stevens-armlab/modular-continuum-manipulator-2.0/Actuation Unit/Nitinol Cable Mount Assembly.SLDASM

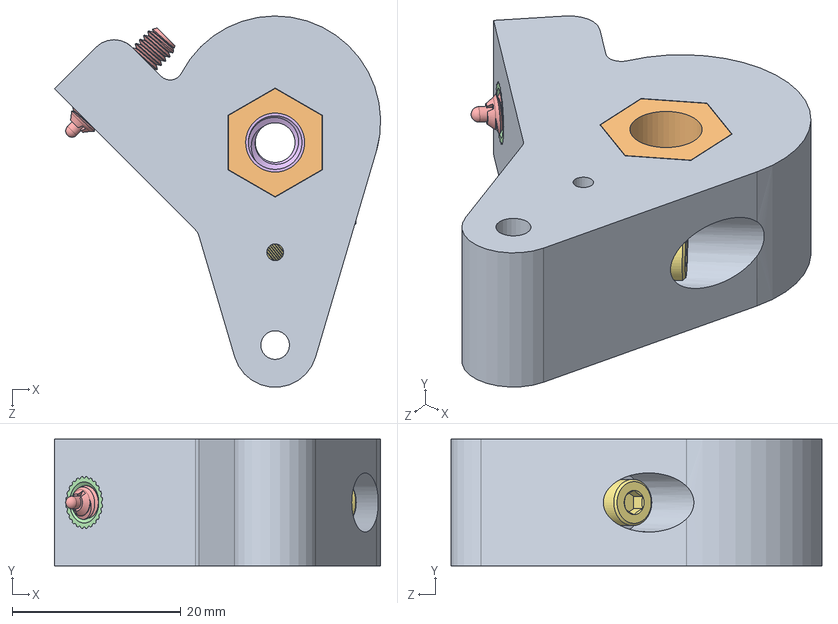
[picture p3: CAD file, 2023-07-17]
Actuation Unit/Nitinol Cable Mount Assembly.SLDASM
38.7 x 15.0 x 44.0 mm
Nitinol Cable Mount V2
Nitinol Cable Mount Cap
M3 - 4.3mm Heat Set Insert
M4 - 8.2mm Heat Set Insert
M4x0.7 - Long-Nose Spring Plunger
1_4-20 - 18-8 SS HEX NUT
M3x0.5 - 8mm - 18-8 SS SOCKET HEAD SCREW
