stevens-armlab/modular-continuum-manipulator-2.0/Continuum Arm Model/Arm Link Assembly.SLDASM

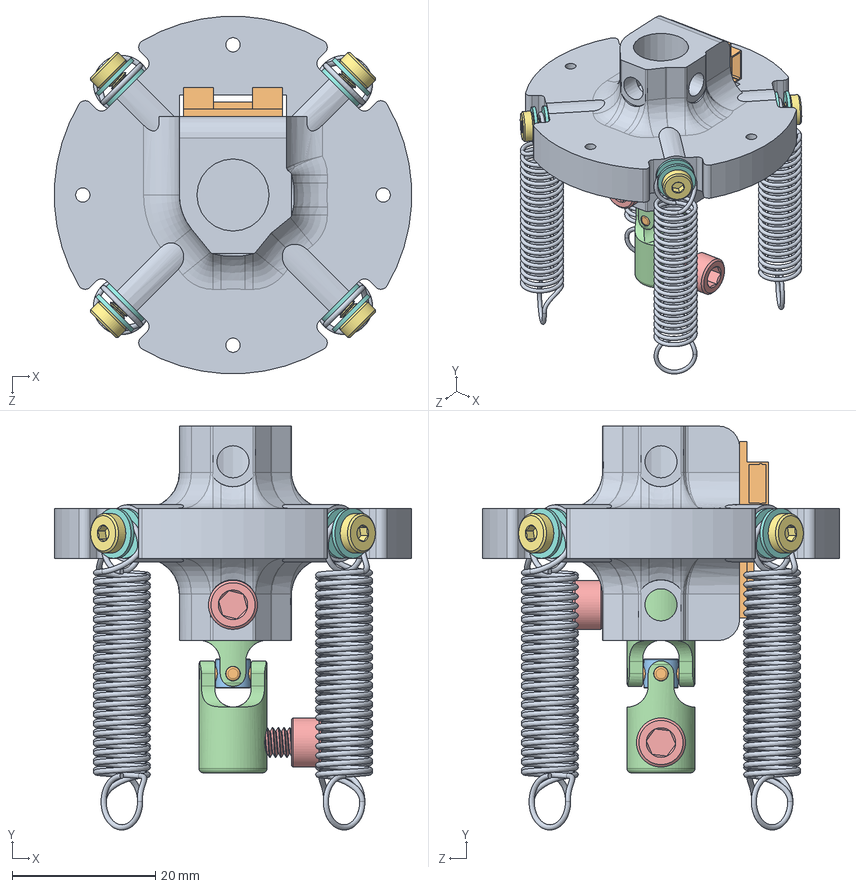
[picture p4: CAD file, 2023-07-17]
Continuum Arm Model/Arm Link Assembly.SLDASM
49.9 x 56.5 x 49.9 mm
Arm Link
VEX Joint Pin x 2
VEX Joint Ball
VEX Joint Link x 2
#8-32 x 0.3125in 18-8 Stainless Steel Socket Head Screw x 2
M3 - 5.7 mm Heat Set Insert x 4
M3x0.5 - 10mm - 18-8 SS LOW PROFILE SOCKET x 4
M3 - 18-8 STAINLESS STEEL FLAT WASHER x 8
0.313in x 1.25in Steel Extension Spring x 4
ZIO BNO080 part
