stevens-armlab/modular-continuum-manipulator-2.0/Waterproof Enclosure/WTE4-ASM-R2/WTE4-ASM-R2.SLDPRT

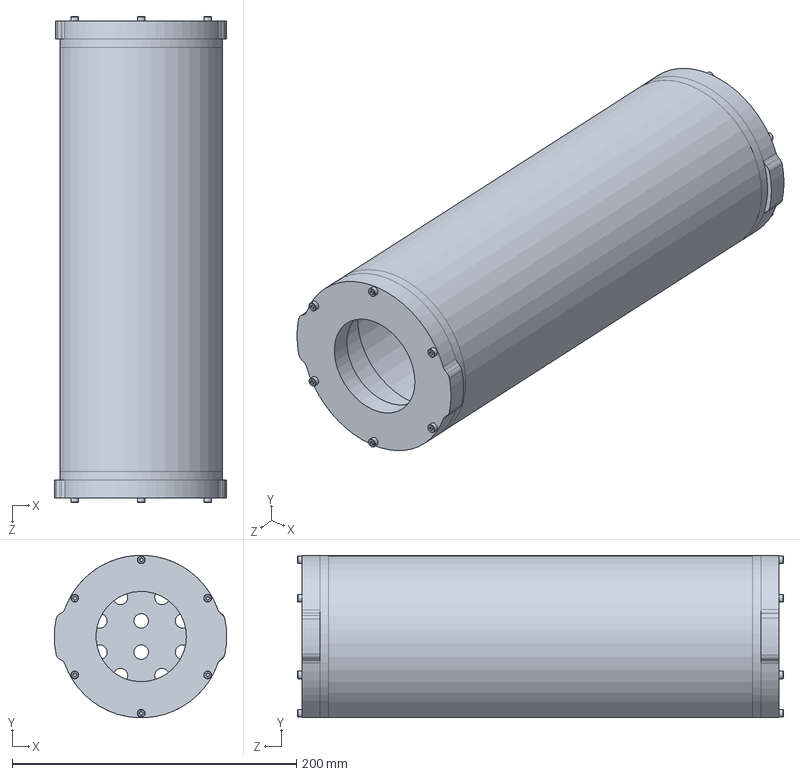
[picture p5: CAD file, 2022-06-02]
Waterproof Enclosure/WTE4-ASM-R2/WTE4-ASM-R2.SLDPRT
121.3 x 114.2 x 341.9 mm
