stevens-armlab/modular-continuum-manipulator-2.0/Actuation Unit/ThinPot Assembly.SLDASM

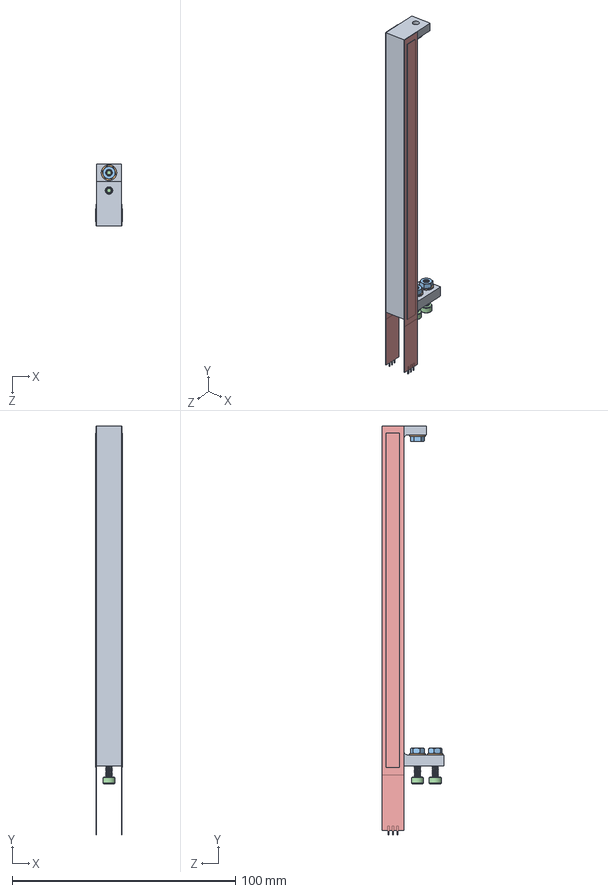
[picture p6: CAD file, 2023-07-17]
Actuation Unit/ThinPot Assembly.SLDASM
12.0 x 183.4 x 28.0 mm
ThinPot Mount 4in
M3 - 18-8 STAINLESS STEEL FLAT WASHER x 3
M3 - 18-8 STAINLESS STEEL HEX NUT x 3
M3x0.5 - 12mm - 18-8 SS SOCKET HEAD SCREW x 2
ThinPot 150mm x 2
