stevens-armlab/modular-continuum-manipulator-2.0/Continuum Arm Model/VEX Universal Joint.SLDASM

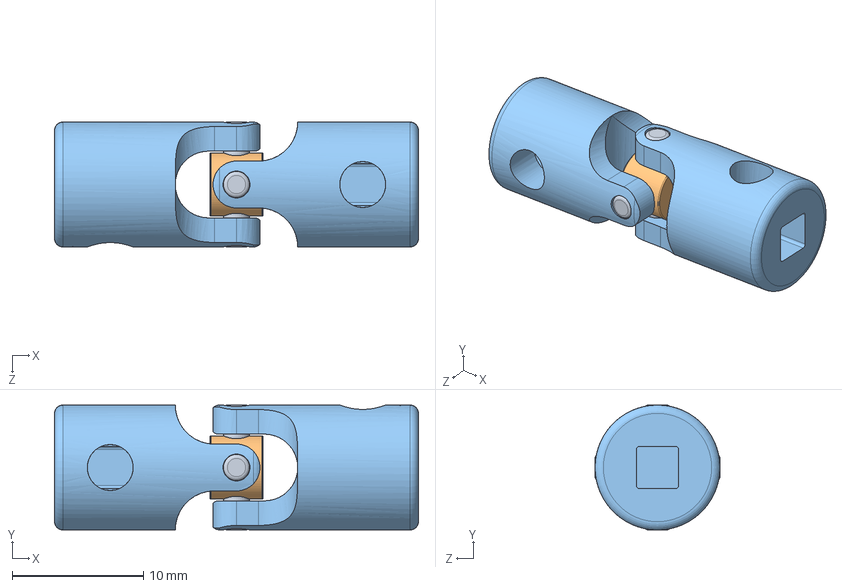
[picture p7: CAD file, 2022-06-02]
Continuum Arm Model/VEX Universal Joint.SLDASM
27.8 x 9.53 x 9.53 mm
VEX Joint Pin x 2
VEX Joint Ball
VEX Joint Link x 2
