stevens-armlab/modular-continuum-manipulator-2.0/Waterproof Enclosure/WTE6-ASM-R1.SLDPRT

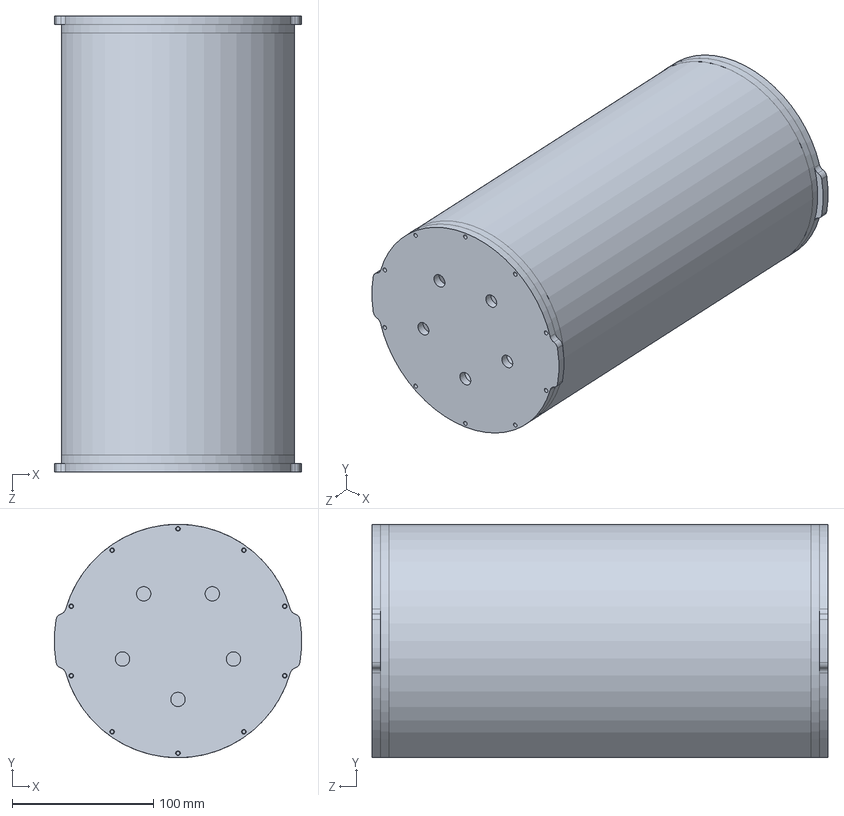
[picture p8: CAD file, 2022-06-02]
Waterproof Enclosure/WTE6-ASM-R1.SLDPRT
174.8 x 165.1 x 322.5 mm
