stevens-armlab/modular-continuum-manipulator-2.0/Bellows/Bellows Medium.SLDPRT

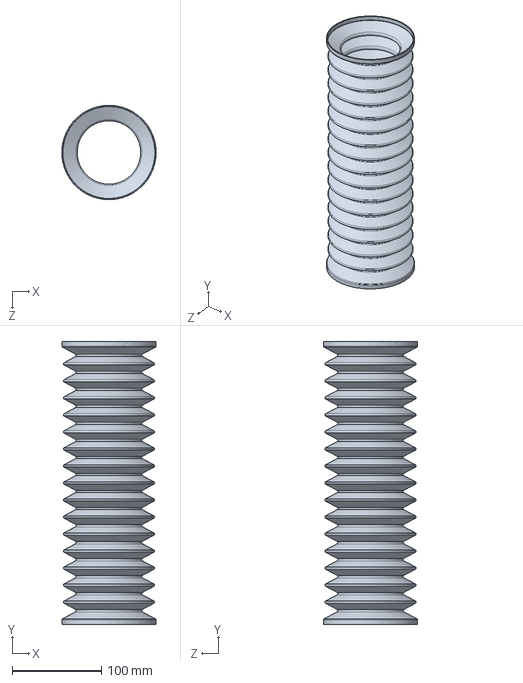
[picture p9: CAD file, 2023-07-17]
Bellows/Bellows Medium.SLDPRT
105.8 x 317.5 x 105.9 mm
