stevens-armlab/modular-continuum-manipulator-2.0/Bellows/Cap Medium.SLDPRT

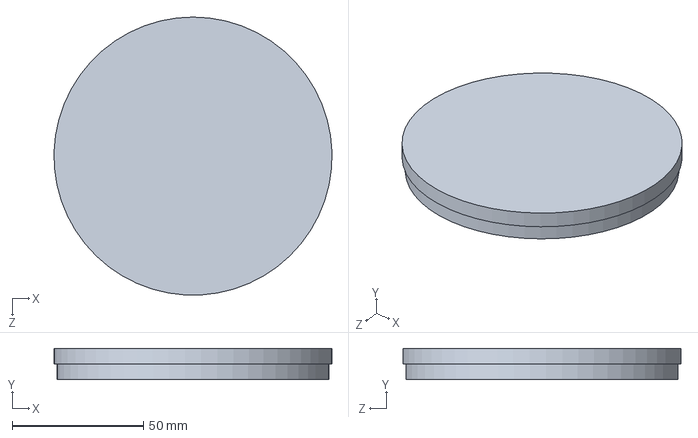
[picture p11: CAD file, 2023-07-17]
Bellows/Cap Medium.SLDPRT
105.9 x 11.9 x 105.8 mm
