stevens-armlab/modular-continuum-manipulator-2.0/Continuum Arm Model/VEX Joint Pin.sldprt

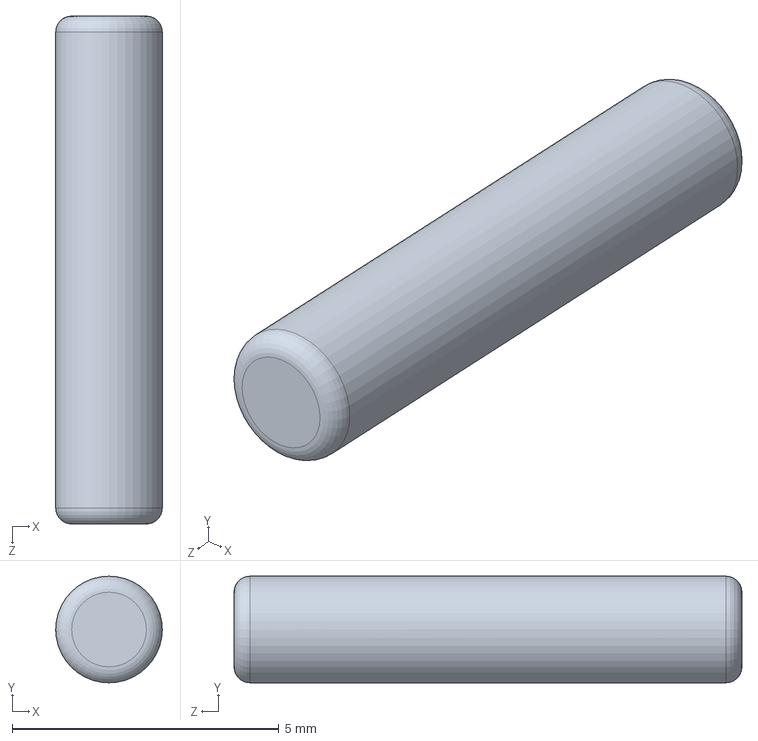
[picture p12: CAD file, 2022-06-02]
Continuum Arm Model/VEX Joint Pin.sldprt
2.00 x 2.00 x 9.53 mm
