stevens-armlab/modular-continuum-manipulator-2.0/Waterproof Enclosure/PENETRATOR-M-BLANK-10-25-R3.SLDPRT

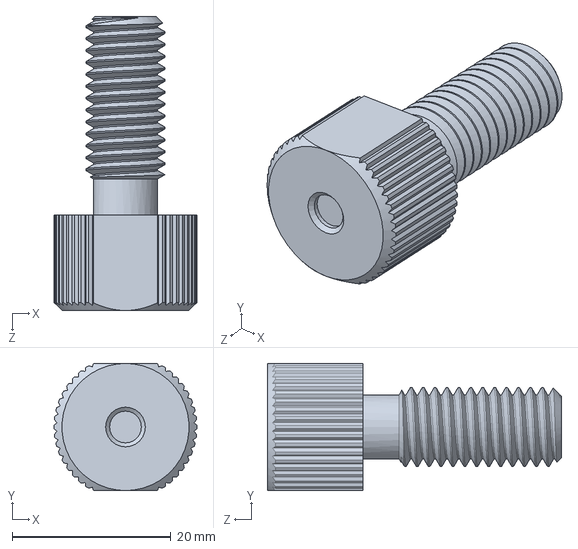
[picture p13: CAD file, 2022-06-02]
Waterproof Enclosure/PENETRATOR-M-BLANK-10-25-R3.SLDPRT
18.0 x 16.0 x 37.0 mm
