stevens-armlab/modular-continuum-manipulator-2.0/Actuation Unit/Nitinol Cable Mount V2.SLDPRT

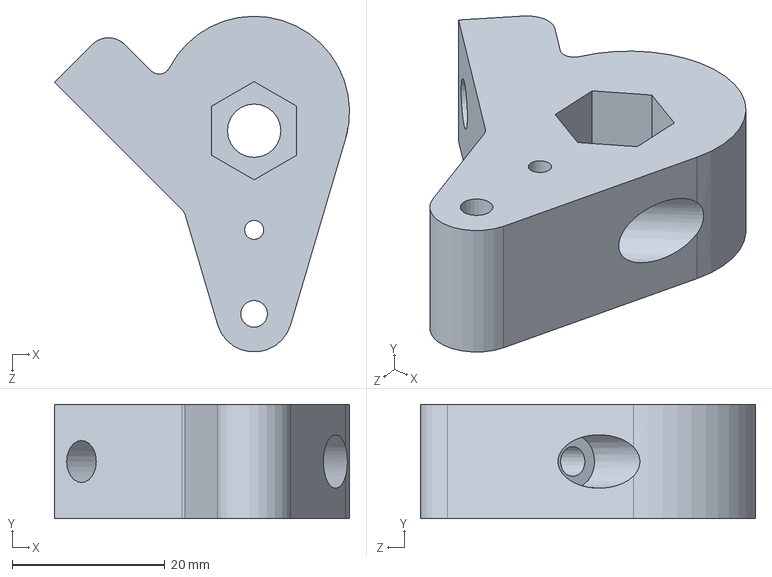
[picture p14: CAD file, 2022-06-16]
Actuation Unit/Nitinol Cable Mount V2.SLDPRT
38.7 x 15.0 x 44.0 mm
