stevens-armlab/modular-continuum-manipulator-2.0/Bellows/Joint Medium.SLDPRT

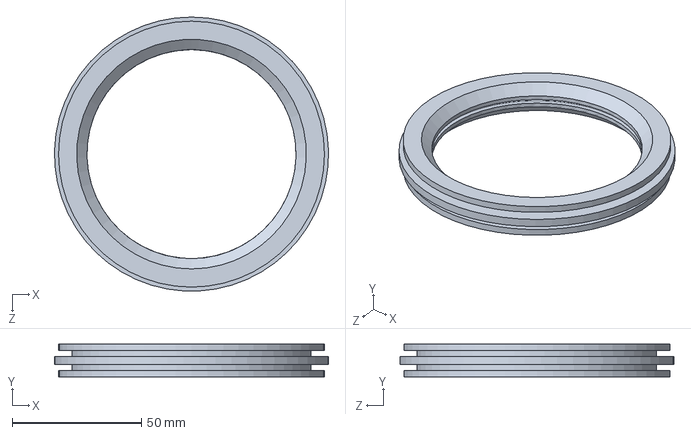
[picture p15: CAD file, 2023-07-17]
Bellows/Joint Medium.SLDPRT
105.9 x 12.7 x 105.8 mm
