stevens-armlab/modular-continuum-manipulator-2.0/Actuation Unit/Standoff Support.SLDPRT

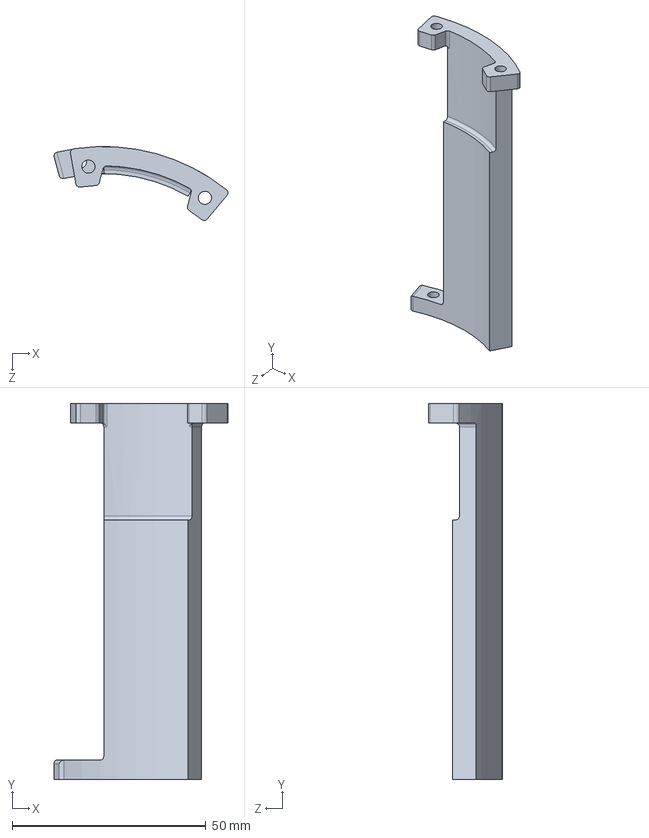
[picture p17: CAD file, 2022-06-16]
Actuation Unit/Standoff Support.SLDPRT
44.9 x 97.0 x 19.1 mm
