stevens-armlab/modular-continuum-manipulator-2.0/Bellows/Disc Medium.SLDPRT

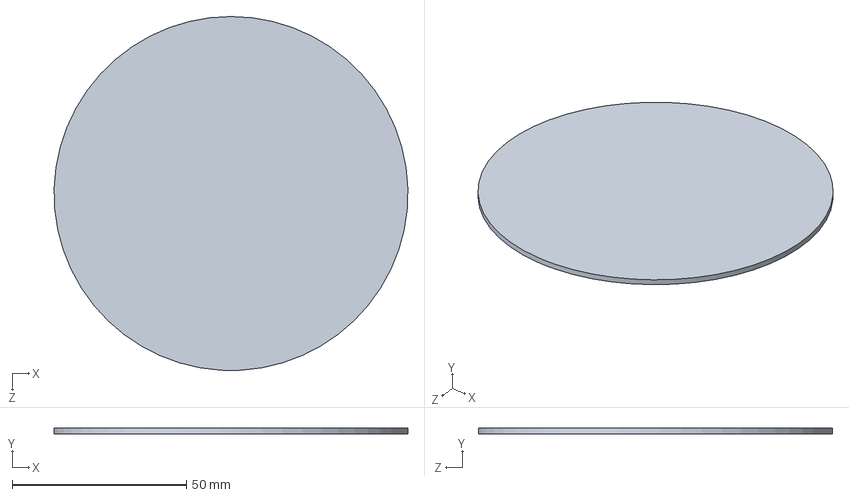
[picture p18: CAD file, 2023-07-17]
Bellows/Disc Medium.SLDPRT
101.6 x 1.59 x 101.6 mm
