stevens-armlab/modular-continuum-manipulator-2.0/Continuum Arm Model/Arm Link.SLDPRT

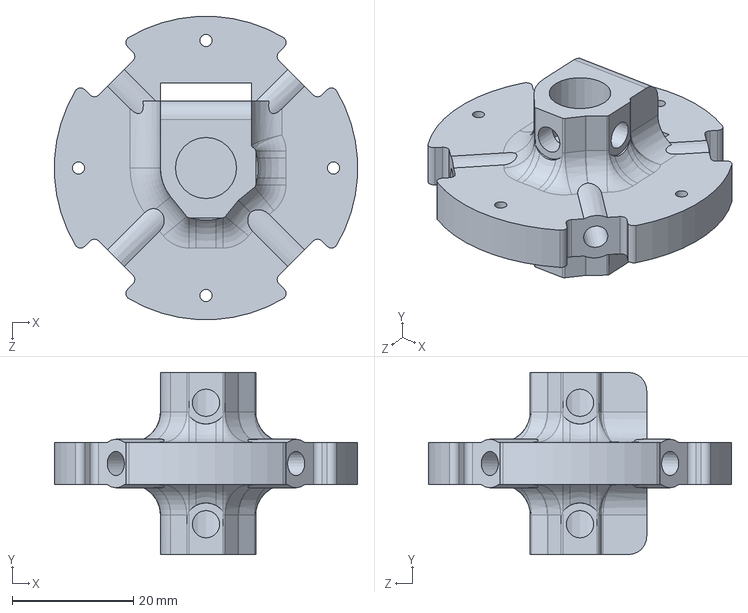
[picture p19: CAD file, 2022-06-02]
Continuum Arm Model/Arm Link.SLDPRT
49.9 x 30.0 x 49.9 mm
