stevens-armlab/modular-continuum-manipulator-2.0/Actuation Unit/ThinPot Mount 4in.SLDPRT

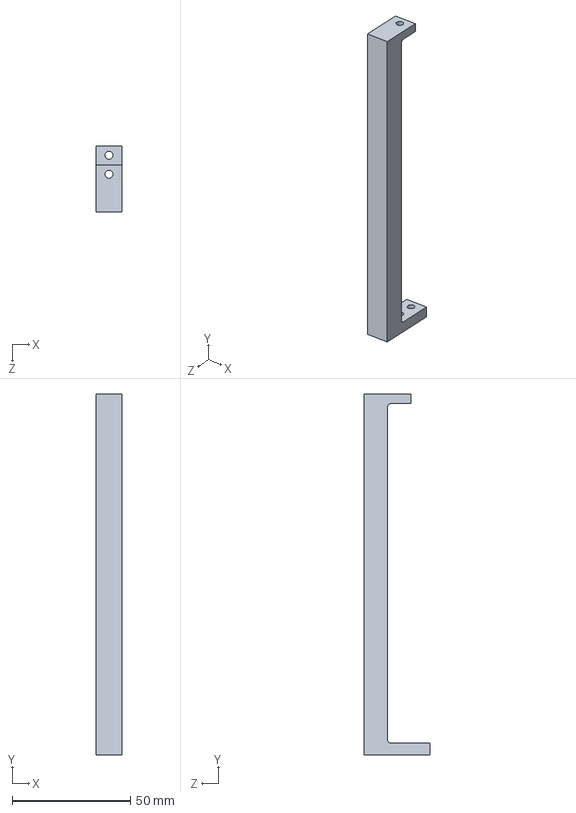
[picture p20: CAD file, 2022-06-02]
Actuation Unit/ThinPot Mount 4in.SLDPRT
11.0 x 152.4 x 28.0 mm
