stevens-armlab/modular-continuum-manipulator-2.0/Bellows/Cap Medium Cutout.SLDPRT

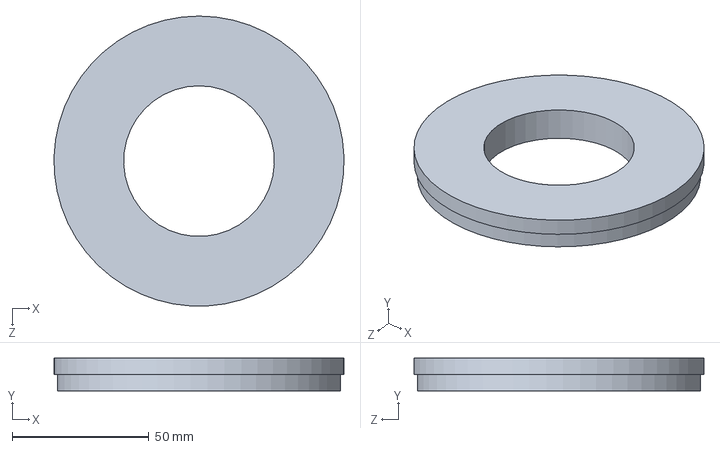
[picture p21: CAD file, 2023-07-17]
Bellows/Cap Medium Cutout.SLDPRT
105.9 x 11.9 x 105.8 mm
