stevens-armlab/modular-continuum-manipulator-2.0/Continuum Arm Model/VEX Joint Ball.sldprt

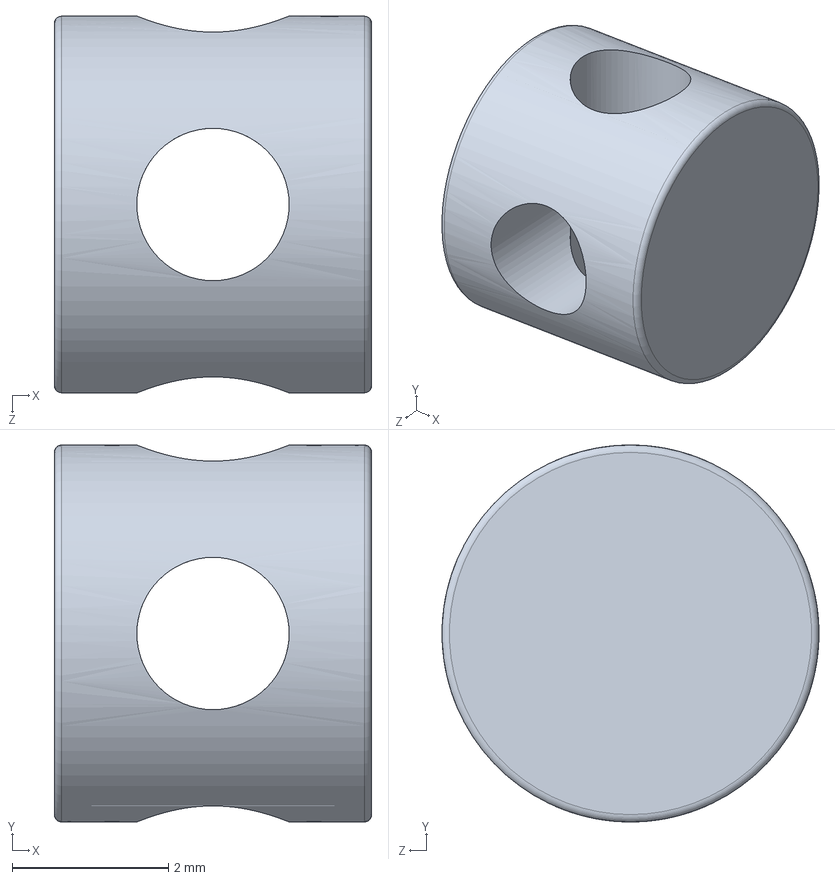
[picture p22: CAD file, 2022-06-02]
Continuum Arm Model/VEX Joint Ball.sldprt
4.06 x 4.83 x 4.83 mm
