stevens-armlab/modular-continuum-manipulator-2.0/Waterproof Enclosure/WTE6-M-END-CAP-R1.SLDPRT

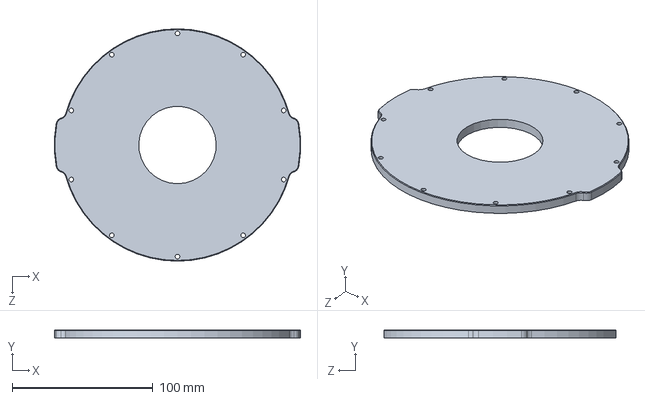
[picture p23: CAD file, 2022-06-02]
Waterproof Enclosure/WTE6-M-END-CAP-R1.SLDPRT
174.8 x 6.00 x 165.1 mm
