stevens-armlab/modular-continuum-manipulator-2.0/Actuation Unit/Top Plate 4in.SLDPRT

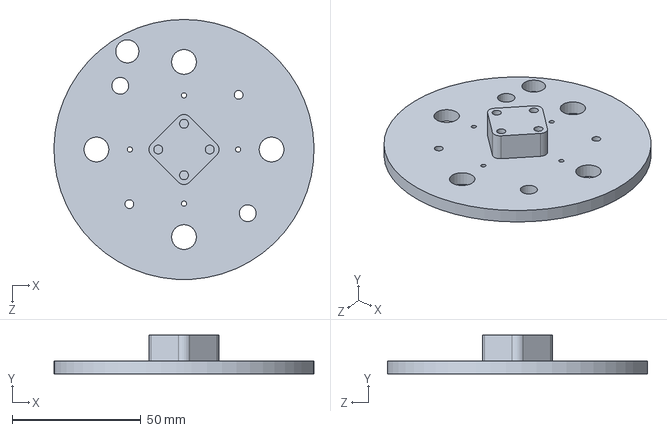
[picture p24: CAD file, 2022-06-02]
Actuation Unit/Top Plate 4in.SLDPRT
101.0 x 15.0 x 101.0 mm
