stevens-armlab/modular-continuum-manipulator-2.0/Bellows/Bellows Medium Bending.SLDPRT

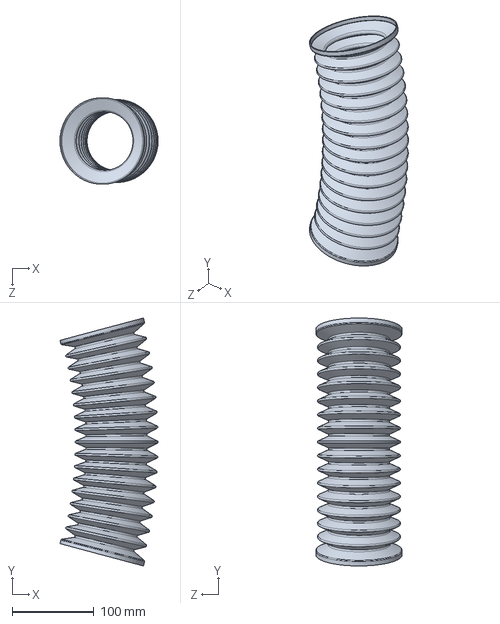
[picture p25: CAD file, 2023-07-17]
Bellows/Bellows Medium Bending.SLDPRT
120.2 x 303.6 x 105.9 mm
