stevens-armlab/modular-continuum-manipulator-2.0/Continuum Arm Model/End Link Nitinol Mount.SLDPRT

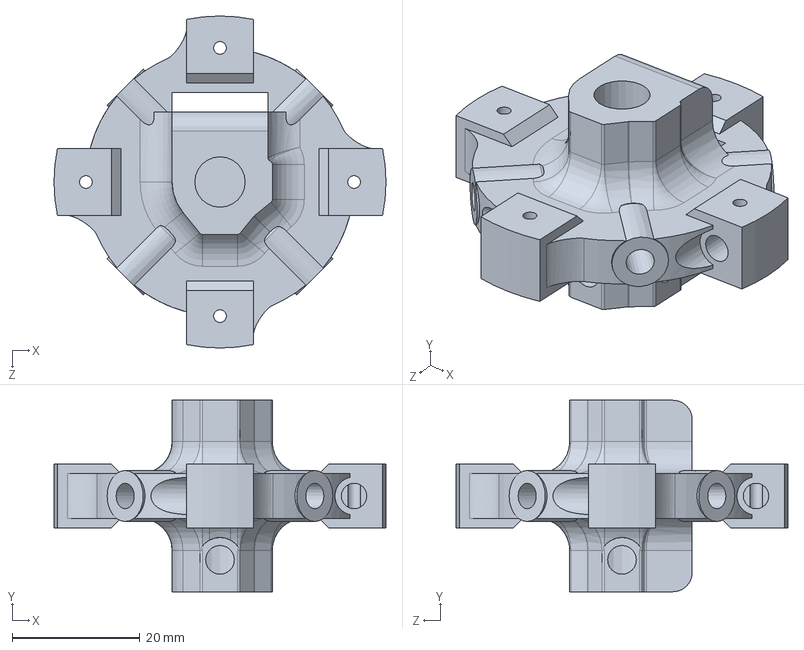
[picture p26: CAD file, 2022-06-02]
Continuum Arm Model/End Link Nitinol Mount.SLDPRT
52.0 x 30.0 x 52.0 mm
