stevens-armlab/modular-continuum-manipulator-2.0/Actuation Unit/Electronics Plate.SLDPRT

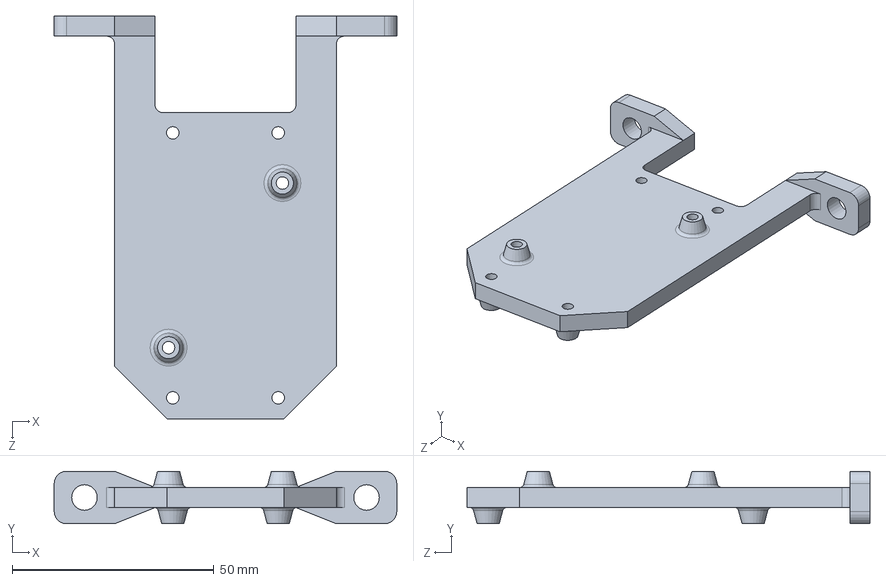
[picture p27: CAD file, 2022-06-02]
Actuation Unit/Electronics Plate.SLDPRT
85.0 x 13.0 x 100.0 mm
