stevens-armlab/modular-continuum-manipulator-2.0/Bellows/Alignment Disc.SLDPRT

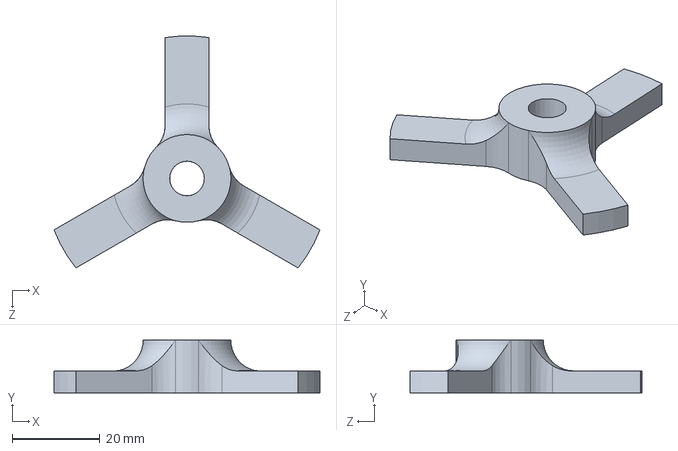
[picture p28: CAD file, 2022-06-02]
Bellows/Alignment Disc.SLDPRT
60.6 x 12.0 x 52.8 mm
