stevens-armlab/modular-continuum-manipulator-2.0/Continuum Arm Model/VEX Joint Link.sldprt

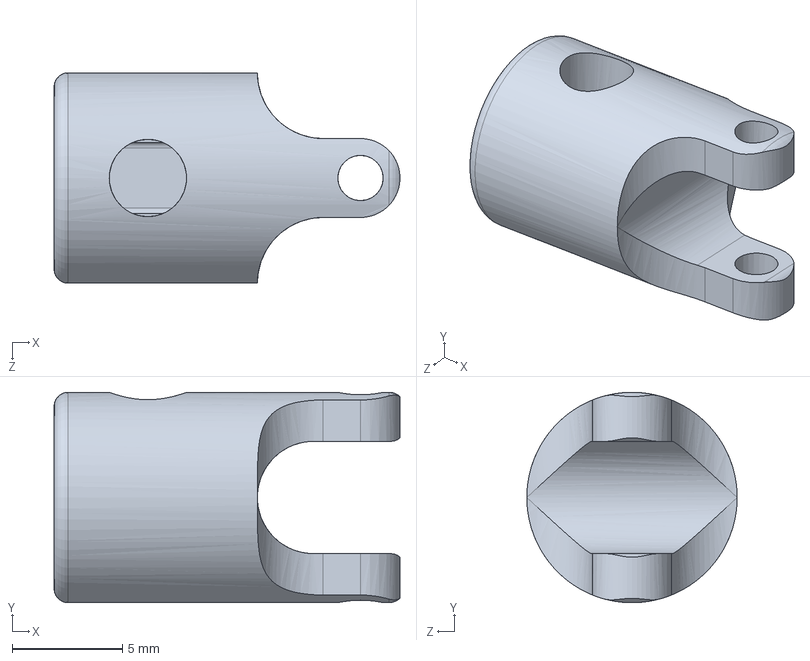
[picture p29: CAD file, 2022-06-02]
Continuum Arm Model/VEX Joint Link.sldprt
15.7 x 9.53 x 9.53 mm
