stevens-armlab/modular-continuum-manipulator-2.0/Waterproof Enclosure/WTE6-M-FLANGE-SEAL-R1.SLDPRT

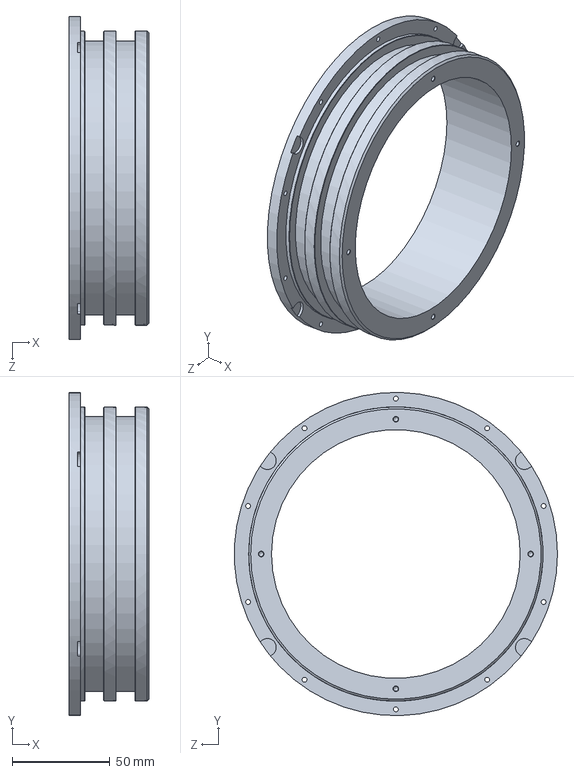
[picture p30: CAD file, 2022-06-02]
Waterproof Enclosure/WTE6-M-FLANGE-SEAL-R1.SLDPRT
41.0 x 165.0 x 165.0 mm
