stevens-armlab/modular-continuum-manipulator-2.0/Continuum Arm Model/ZIO QWIIC MUX.SLDPRT

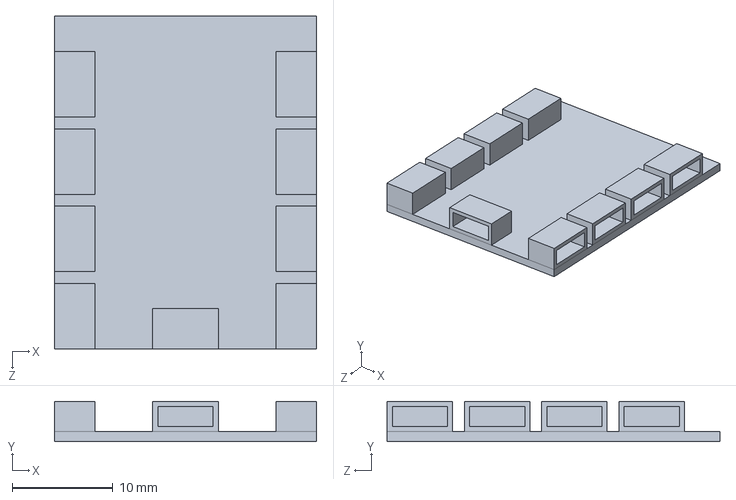
[picture p31: CAD file, 2022-06-02]
Continuum Arm Model/ZIO QWIIC MUX.SLDPRT
26.0 x 4.00 x 33.0 mm
