stevens-armlab/modular-continuum-manipulator-2.0/Waterproof Enclosure/WTE6-P-TUBE-12-R1.SLDPRT

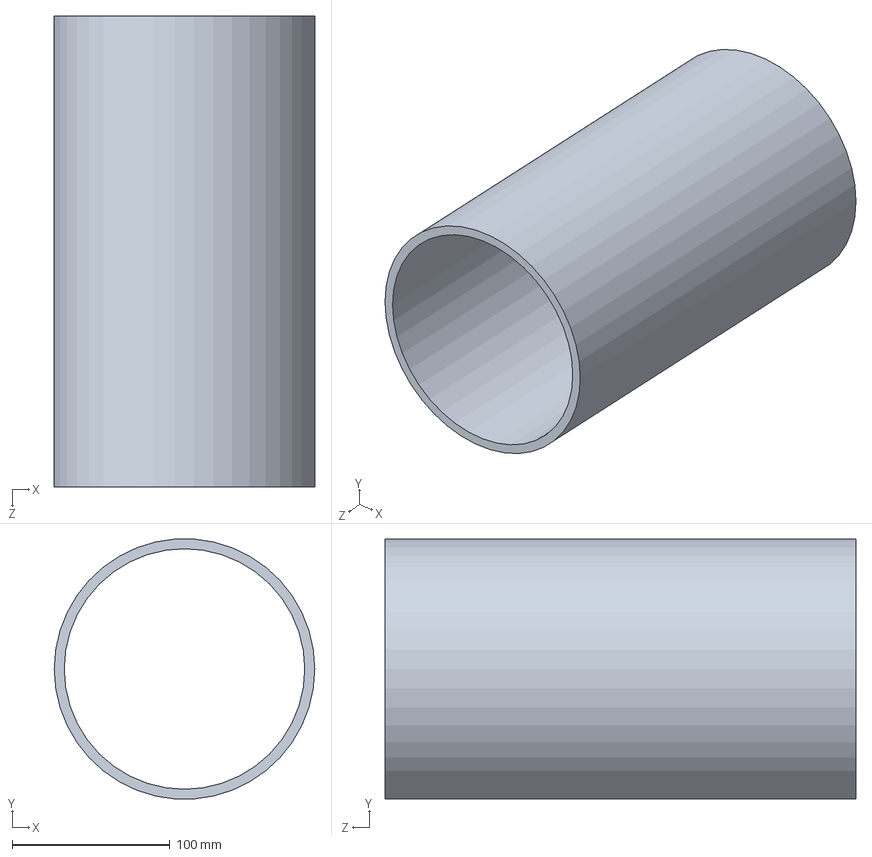
[picture p32: CAD file, 2022-06-02]
Waterproof Enclosure/WTE6-P-TUBE-12-R1.SLDPRT
165.1 x 164.6 x 298.4 mm
