stevens-armlab/modular-continuum-manipulator-2.0/Continuum Arm Model/Arm Base Lower.SLDPRT

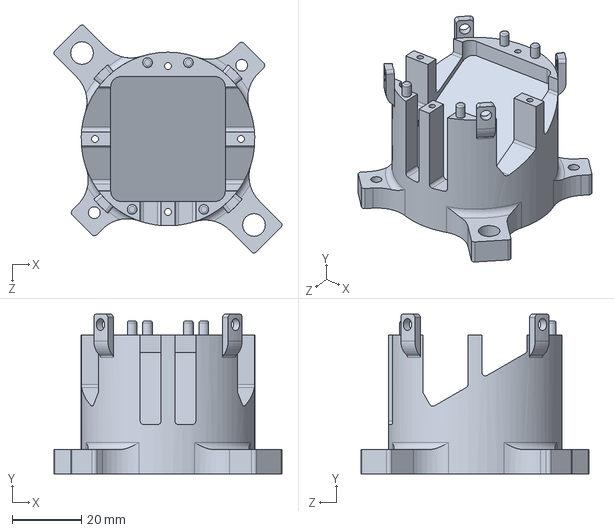
[picture p33: CAD file, 2022-06-02]
Continuum Arm Model/Arm Base Lower.SLDPRT
65.6 x 46.0 x 65.6 mm
