stevens-armlab/modular-continuum-manipulator-2.0/Waterproof Enclosure/VENT-M-PLUG-10-A-R3.SLDPRT

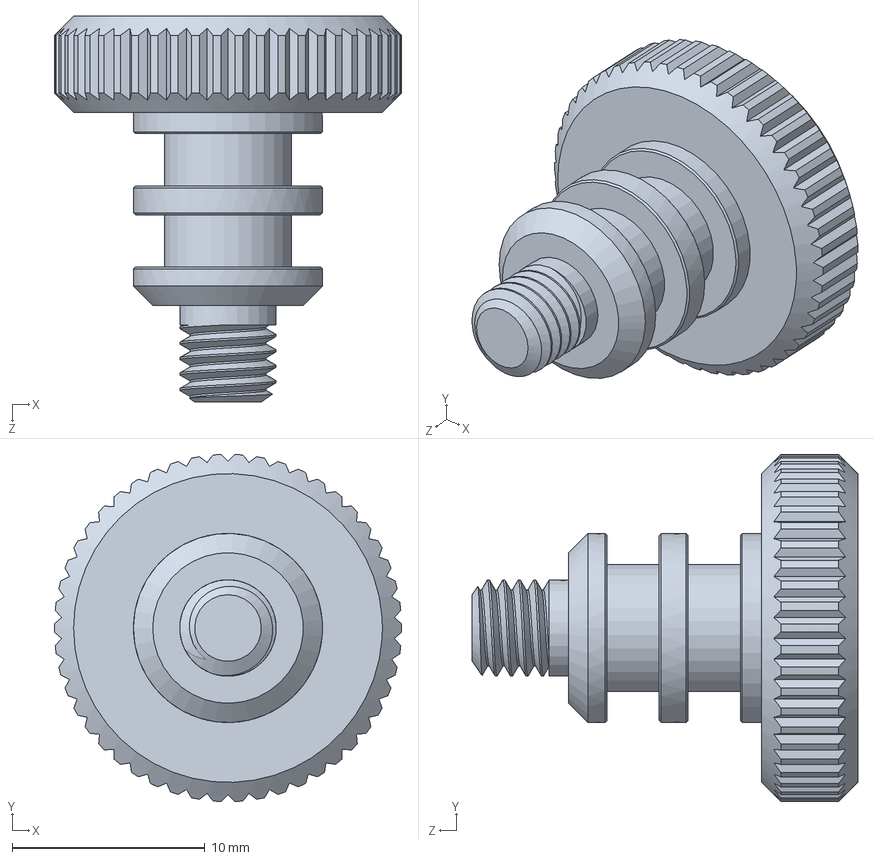
[picture p34: CAD file, 2022-06-02]
Waterproof Enclosure/VENT-M-PLUG-10-A-R3.SLDPRT
18.0 x 18.0 x 20.0 mm
