stevens-armlab/modular-continuum-manipulator-2.0/Actuation Unit/ThinPot 150mm.SLDPRT

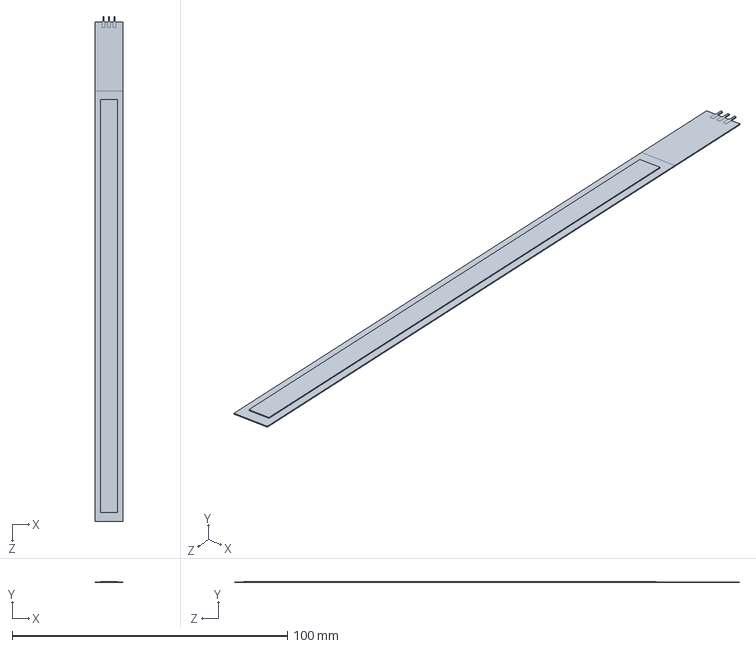
[picture p35: CAD file, 2022-06-02]
Actuation Unit/ThinPot 150mm.SLDPRT
10.0 x 0.51 x 183.4 mm
