stevens-armlab/modular-continuum-manipulator-2.0/Continuum Arm Model/ZIO BNO080 part.SLDPRT

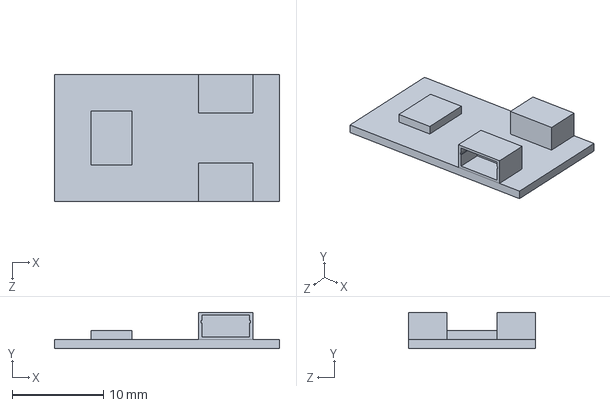
[picture p36: CAD file, 2022-06-02]
Continuum Arm Model/ZIO BNO080 part.SLDPRT
24.7 x 4.00 x 13.9 mm
