stevens-armlab/modular-continuum-manipulator-2.0/Actuation Unit/Nitinol Cable Mount Cap.SLDPRT

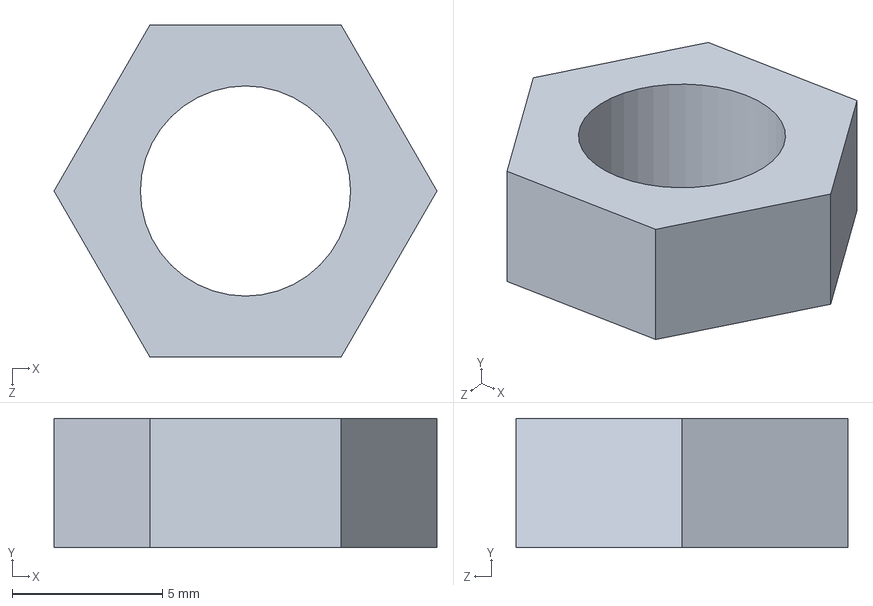
[picture p37: CAD file, 2022-06-02]
Actuation Unit/Nitinol Cable Mount Cap.SLDPRT
12.8 x 4.30 x 11.1 mm
