stevens-armlab/modular-continuum-manipulator-2.0/Continuum Arm Model/Arm Base Upper.SLDPRT

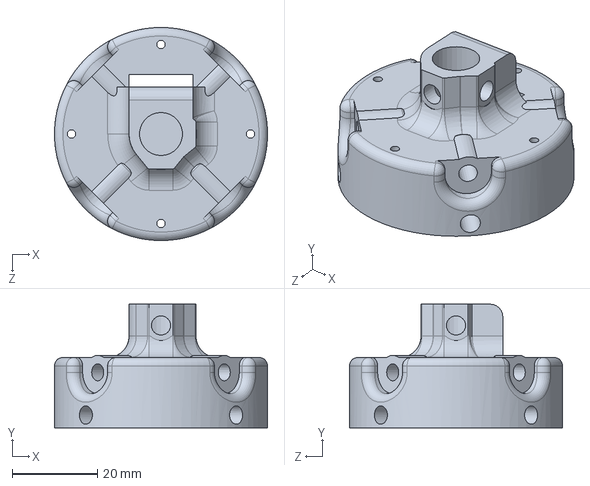
[picture p38: CAD file, 2022-06-02]
Continuum Arm Model/Arm Base Upper.SLDPRT
50.0 x 29.0 x 50.0 mm
