stevens-armlab/modular-continuum-manipulator-2.0/Actuation Unit/XL-330.SLDASM

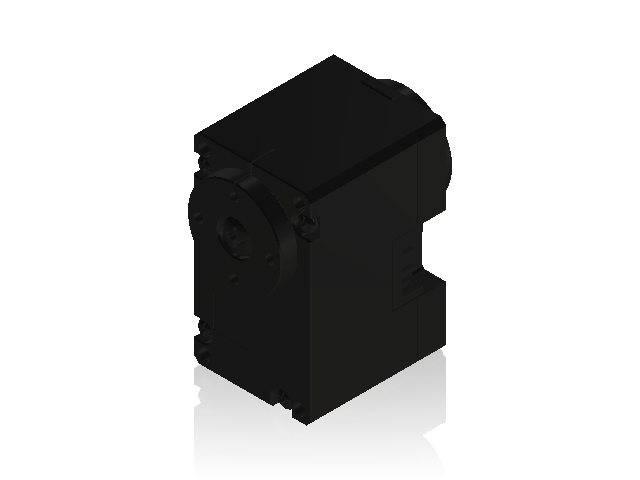
[picture p39: CAD file, 2022-06-02]
Actuation Unit/XL-330.SLDASM
DC15_A01_CASE_M_DUMMY.stp
DC15_A01_CASE_F_DUMMY.stp
DC15_A01_CASE_B_DUMMY.stp
DC15_A01_HORN_DUMMY.stp
DC15_A01_LED_CAP2_DUMMY.stp
PHS_1_7X20_5_DC10.stp x 4
BTS2_M2_6X8.stp x 2
DC15_A01_HORN_IDLE2_DUMMY.stp
DC15_A01_IDLE_CAP_DUMMY.stp
B3B-EH.stp x 2
