stevens-armlab/modular-continuum-manipulator-2.0/(list of files, cad)

Other CAD files:
Actuation Unit/Base Plate.SLDPRT
Actuation Unit/Lead Screw Mount.SLDPRT
Actuation Unit/Nitinol Cable Mount.SLDPRT
Continuum Arm Model/VEX Joint Set Screw.sldprt
Fasteners/#8-32 x 0.3125in 18-8 Stainless Steel Socket Head Screw.SLDPRT
Fasteners/0.313in x 1.25in Steel Extension Spring.SLDPRT
Fasteners/1_4-20 - 1 in - 18-8 SS SOCKET HEAD SCREW.SLDPRT
Fasteners/1_4-20 - 18-8 SS HEX NUT.SLDPRT
Fasteners/1_4-20 - 5_8 in - 18-8 SS SOCKET HEAD SCREW.SLDPRT
Fasteners/1_4-20 - 6 in Female Hex Standoff.SLDPRT
Fasteners/1_4-20 Precision Acme Lead Screw.SLDPRT
Fasteners/3mm x 10mm M2 Shoulder Screw.SLDPRT
Fasteners/3mm x 8mm M2 Shoulder Screw.SLDPRT
Fasteners/Linear Motion Shaft - 0.125in x 6in.SLDPRT
Fasteners/M2 - 16mm - 18-8 SS SOCKET HEAD SCREW.SLDPRT
Fasteners/M2 - 18-8 SS FLAT WASHER.SLDPRT
Fasteners/M2 - 6mm - THREAD FORMING SCREW.SLDPRT
Fasteners/M2 - STEEL HEX NUT.SLDPRT
Fasteners/M3 - 10mm Male-Female Hex Standoff.SLDPRT
Fasteners/M3 - 18-8 STAINLESS STEEL FLAT WASHER.SLDPRT
Fasteners/M3 - 18-8 STAINLESS STEEL HEX NUT.SLDPRT
Fasteners/M3 - 4.3mm Heat Set Insert.SLDPRT
Fasteners/M3 - 40mm Female Hex Standoff.SLDPRT
Fasteners/M3 - 45mm Female Hex Standoff.SLDPRT
Fasteners/M3 - 5.7 mm Heat Set Insert.SLDPRT
Fasteners/M3x0.5 - 10mm - 18-8 SS HEX HEAD SCREW.SLDPRT
Fasteners/M3x0.5 - 10mm - 18-8 SS LOW PROFILE SOCKET.SLDPRT
Fasteners/M3x0.5 - 12mm - 18-8 SS SOCKET HEAD SCREW.SLDPRT
Fasteners/M3x0.5 - 16mm - 18-8 SS SOCKET HEAD SCREW.SLDPRT
Fasteners/M3x0.5 - 20mm - 18-8 SS SOCKET HEAD SCREW.SLDPRT
Fasteners/M3x0.5 - 4mm - 18-8 SS SET SCREW.SLDPRT
Fasteners/M3x0.5 - 8mm - 18-8 SS BUTTON HEAD SCREW.SLDPRT
Fasteners/M3x0.5 - 8mm - 18-8 SS SOCKET HEAD SCREW.SLDPRT
Fasteners/M4 - 8.2mm Heat Set Insert.SLDPRT
Fasteners/M4x0.7 - Long-Nose Spring Plunger.SLDPRT
Fasteners/M6 - 7.9mm Heat Set Insert.SLDPRT
Fasteners/Nylon Sleeve Bearing 1_4in.SLDPRT
Waterproof Enclosure/End Cap Drawing.SLDDRW
Waterproof Enclosure/PENETRATOR-M-BOLT-6MM-10-25-R2.SLDPRT
Waterproof Enclosure/PENETRATOR-M-NUT-10-8-R2.SLDPRT
Waterproof Enclosure/VENT-M-BOLT-10-25-A-R4.SLDPRT
