stevens-armlab/modular-continuum-manipulator-2.0/Assembly Instructions/Actuator Assembly/Actuator 9.PNG

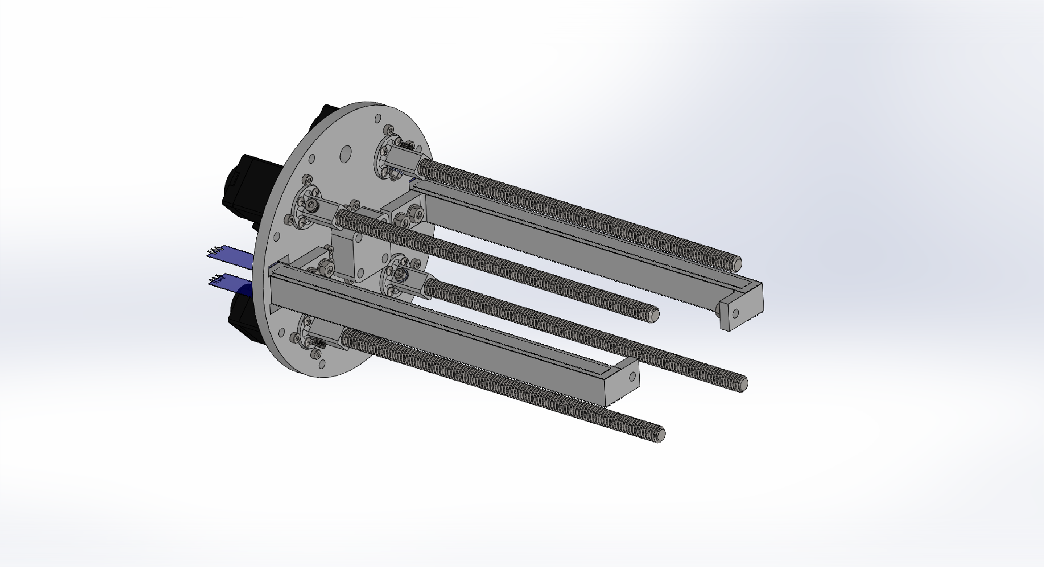
Assembly Instructions/Actuator Assembly/Actuator 9.PNG
