stevens-armlab/modular-continuum-manipulator-2.0/Assembly Instructions/Actuator Assembly/Nitinol Mount Assembly/NCM 7.PNG

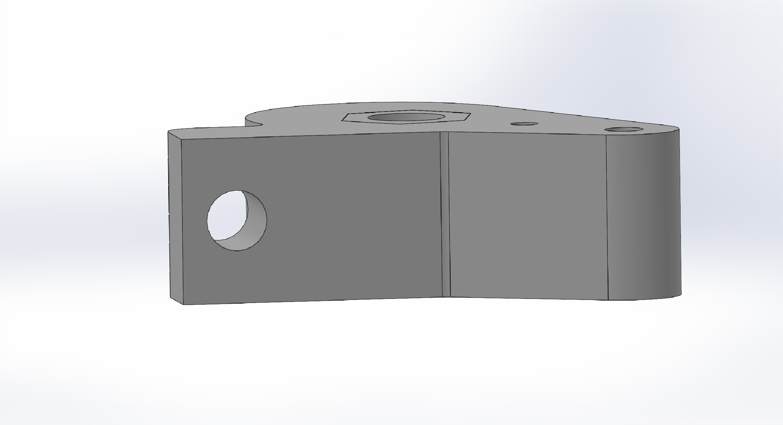
Assembly Instructions/Actuator Assembly/Nitinol Mount Assembly/NCM 7.PNG
