stevens-armlab/modular-continuum-manipulator-2.0/Assembly Instructions/Actuator Assembly/ThinPot Assembly/ThinPot 1.PNG

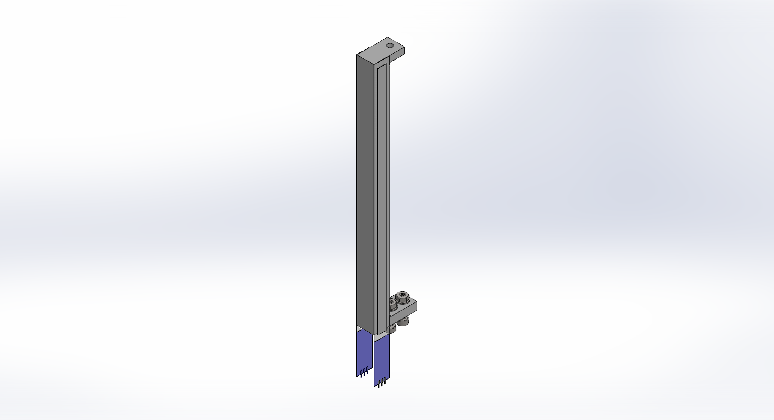
Assembly Instructions/Actuator Assembly/ThinPot Assembly/ThinPot 1.PNG
