stevens-armlab/modular-continuum-manipulator-2.0/Assembly Instructions/Arm Assembly/Arm 16.PNG

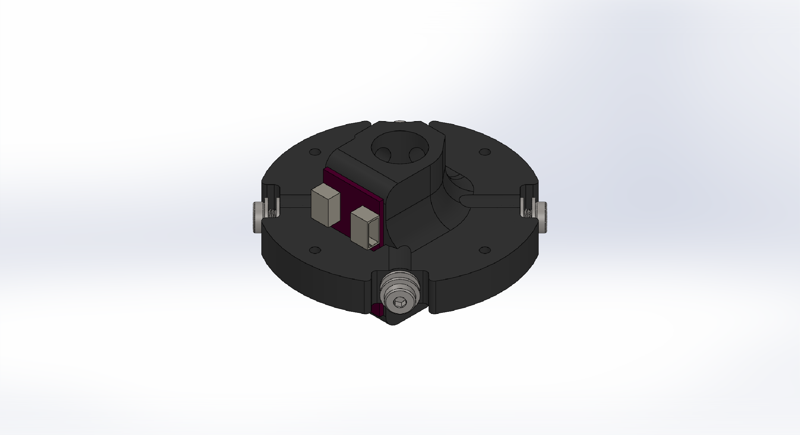
Assembly Instructions/Arm Assembly/Arm 16.PNG
