stevens-armlab/modular-continuum-manipulator-2.0/Assembly Instructions/Full Assembly/Full Assembly 5.PNG

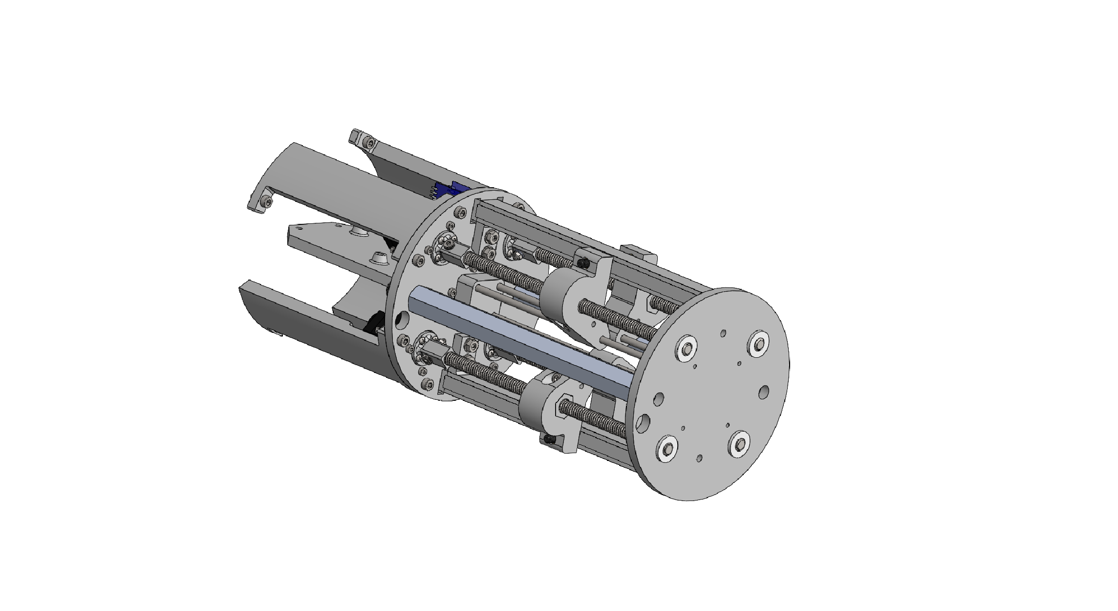
Assembly Instructions/Full Assembly/Full Assembly 5.PNG
