stevens-armlab/modular-continuum-manipulator-2.0/(commit log)

2022-06-02 Initial CAD upload
    [#8-32 x 0.3125in 18-8 Stainless Steel Socket Head Screw.SLDPRT, 0.313in x 1.25in Steel Extension Spring.SLDPRT, 1_4-20 - 1 in - 18-8 SS SOCKET HEAD SCREW.SLDPRT, 1_4-20 - 18-8 SS HEX NUT.SLDPRT, 1_4-20 - 5_8 in - 18-8 SS SOCKET HEAD SCREW.SLDPRT, 1_4-20 - 6 in Female Hex Standoff.SLDPRT, 1_4-20 Precision Acme Lead Screw.SLDPRT, 3mm x 10mm M2 Shoulder Screw.SLDPRT]
2022-06-16 Modified cable mount and standoff support length increased
    [Nitinol Cable Mount Assembly.SLDASM, Nitinol Cable Mount V2.SLDPRT, Standoff Support.SLDPRT]
2023-07-17 Added assembly instructions, file cleanup
    [Alignment Disc.SLDPRT, Arm Link Assembly.SLDASM, Base Plate.SLDPRT, Bellows 4in Bending.SLDPRT, Bellows 4in.SLDPRT, Bellows Alignment Disc.SLDPRT, Bellows Cap 4in.SLDPRT, Bellows Cap Cutout 4in.SLDPRT]
2023-07-17 Added PDF of assembly guide
